Tinkerforge/tng-ao-4u-4i/hardware/ao-4u-4i.kicad_pcb

## KiCad design hardware/ao-4u-4i.kicad_pcb (2020-09-10)

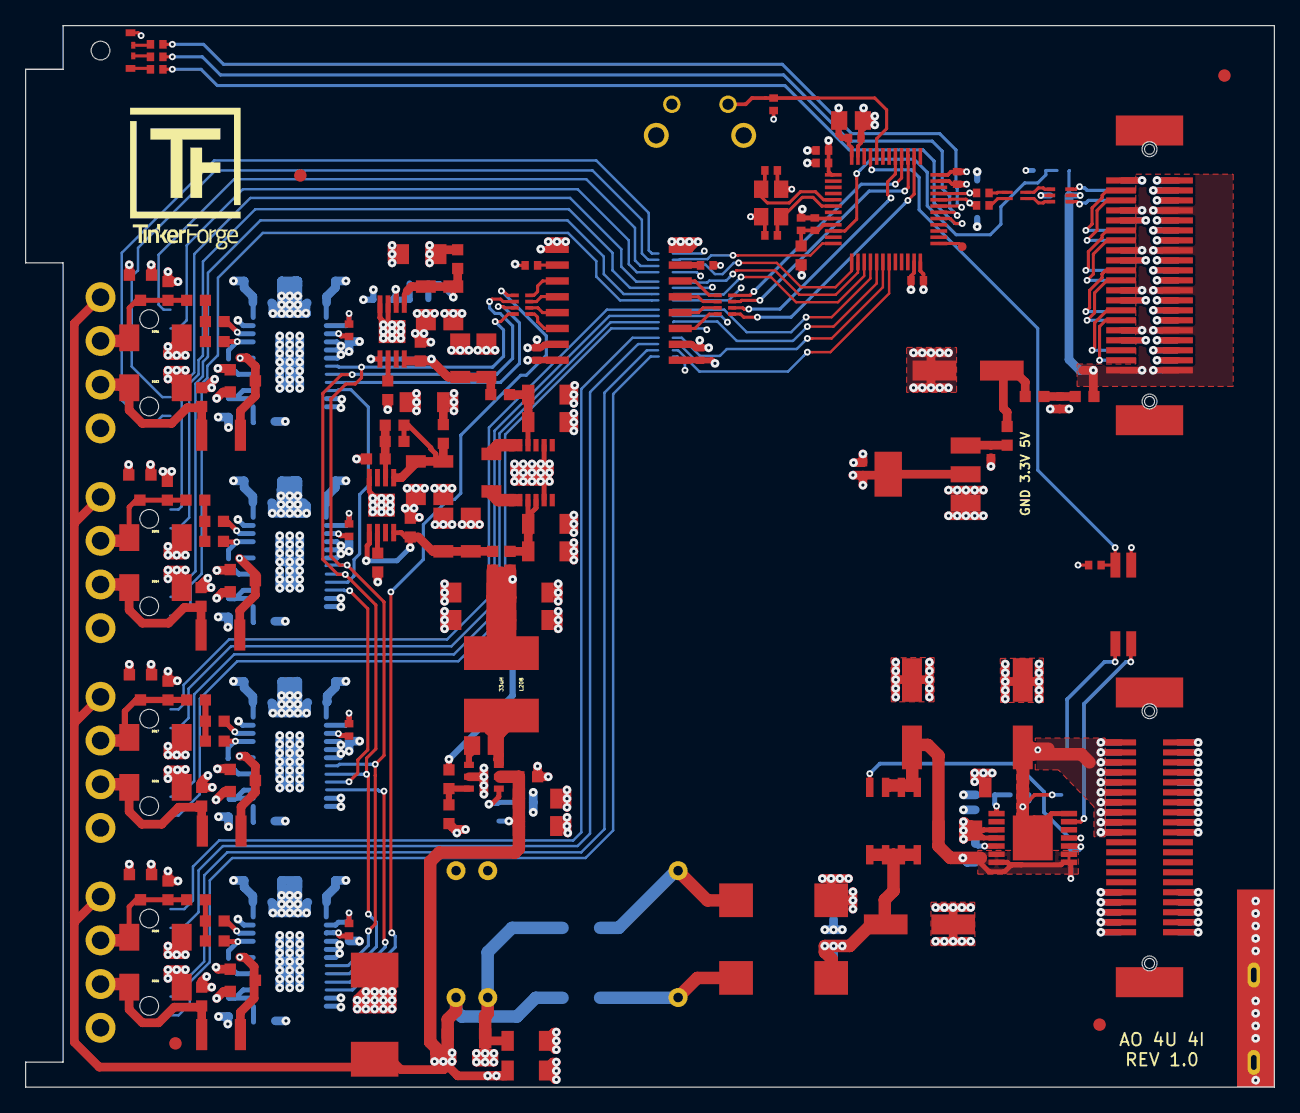
[picture p1: board ao-4u-4i.kicad_pcb from above]

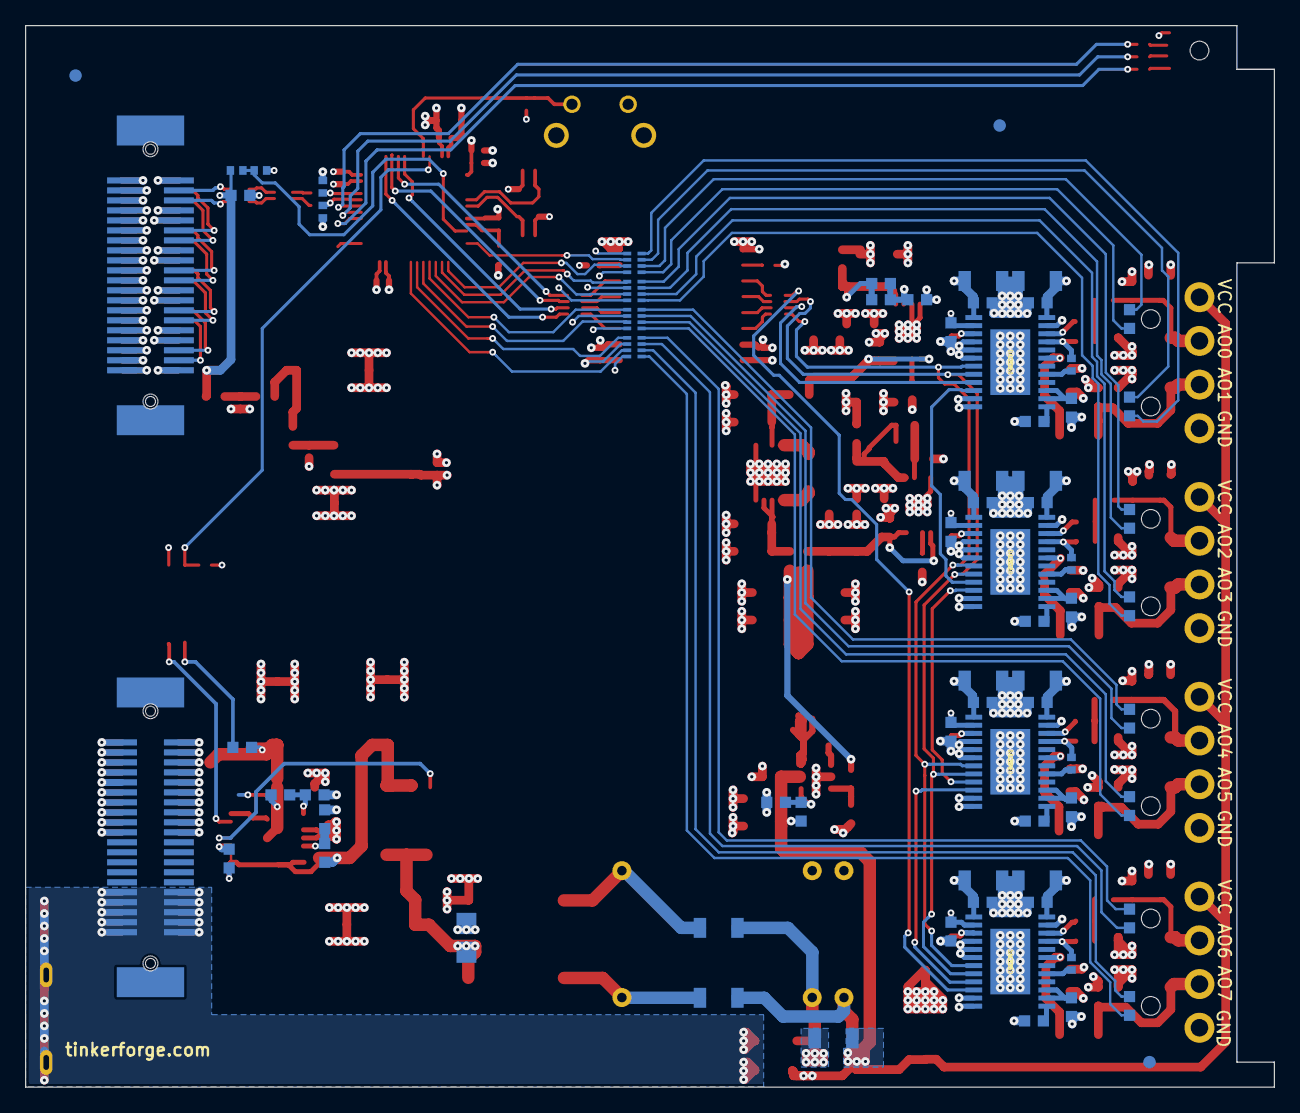
[picture p2: board ao-4u-4i.kicad_pcb from below]

Board: 4 copper layers, 100.0 x 85.0 mm, 224 parts (73 on the bottom side), 158 nets.

Parts:
C101, C102, C116, C117: 1uF; C0402F
C103, C104, C105, C106, C107, C112, C233, C235: 100nF; C0402F
C108, C109: 33pF; C0402F
C110: 10uF; C0805E
C111, C122, C123, C124: 100uF/35V; ELKO_63
C113, C114: 47pF; C0402F
C115: 2.2uF; C0603F
C118: 10uF/50V; C1206
C119, C120: 0; C1206
C121, C125, C126: 10uF/35V; C1206
C127, C128: 1nF/2kV; C1206
C201, C202, C203, C204, C207, C209, C211, C212, C213, C215, C217, C218, C219, C220, C221, C222, C225, C227, C229, C230, C231, C234, C237, C238, C245, C246, C258: 100nF/30V; C0603F
C205, C206, C223, C224: 1nF; C0402F
C208, C210, C214, C216, C226, C228, C232, C236, C239, C242: 4.7uF/30V; C1206
C240, C241, C243, C244, C247, C251, C252, C255, C257, C259, C260, C261, C262, C263, C264, C265, C266, C267: 4.7uF/50V; C1206
C248, C249, C253, C254: 10nF/30V; C0603F
C250: 100nF/100V; C0805E
C256: 1uF/50V; C1206
D101: 3.0SMI30CATR; SMC
D201, D202, D213, D214, D217, D218, D221, D222: SMBJ18CA; SMB
D203, D204, D205, D206, D207, D208, D209, D210: LED; LED-LP
D211, D212, D215, D216, D219, D220, D223, D224: CDSOT23-T15C; SOT23-3
Fiducial_Mark: VAL**; Fiducial_Mark
Fiducial_Mark#2, Fiducial_Mark#3, Fiducial_Mark#4, Fiducial_Mark#5, Fiducial_Mark#6, Fiducial_Mark#7: VAL**; Fiducial_Mark
J101: TNG-Power-TOP; TNG-40-TOP
J102: TNG-Power-BTM; TNG-40-BTM
J103: TNG-Data-TOP; TNG-40-TOP
J104: TNG-Data-BTM; TNG-40-BTM
L101: FB; R0603F
L102, L103, L104: INDUCTs; R0603F
L105: 744230900; WE-CNSW-0603
L201, L202, L203, L204, L205, L206, L207, L209, L210: FB; C0603F
L208: 33uH; SRN6045
LED101: EASV3015RGBA0; LED-RGB-LP
P102: Debug; DEBUG_PAD
P103: PE; PE_Hook
P201: OUTPUT0; OQ_4P
P202: OUTPUT1; OQ_4P
P203: OUTPUT2; OQ_4P
P204: OUTPUT3; OQ_4P
Q101: FDS8449; SOIC-8-MOSFET
R101, R107, R108: 1k; R0402F
R102, R105, R221, R254: 0; R0402F
R103, R104: 22; R0402F
R106: 56; R0402F
R109, R209, R210, R219, R220: 10k; R0402F
R110, R115: 10k; R0603F
R111, R112: DNP; R0603F
R113: 22; R0603F
R114: 68k; R0603F
R116: VC1206K201R030; R1206
R201, R202, R204, R205, R211, R212, R214, R215: 15; R0603F
R203, R206, R213, R216: 15 1/2W 1%; R1210
R207, R208, R217, R218: 15k 0.1%; R0603F
R222: 127k; R0603F
R223: 1.37M; R0603F
R224, R227: 110k; R0603F
R225, R226: 9.42k; R0603F
R228: 374k; R0603F
R229: 22.1k; R0603F
RP201, RP202, RP203, RP204, RP205, RP206: 470; 4X0402
SW101: BOOT; TACT-6MM-HOR
T101: 744273222; WE-SL5
U101: STM32F070CBT6; LQFP48
U102: AZ1117EH; SOT-223
U103: 82400152; SOT563-SPEC
U104: DNP; TEL10
U105: TLP293; SOP4
U106: STEF01; HTSSOP14
U201, U202, U204, U205: DAC8760; TSSOP24-44-PWR
U203: ISO7741DWR; SOIC16_WIDE
U206: TPS560430YDBVR; SOT23-6
U207: TPS7A3001DGNR; MSOP-8-EP
U208: TPS7A4901DGNR; MSOP-8-EP
U209: LTC3261; MSOP12_EXP
X101: 8MHz; CRYSTAL_3225

Connections:
3V3: C101.1, C103.1, C104.1, C105.1, C106.1, C110.1, C116.1, C235.1, L101.1, LED101.1, R109.2, R254.1, RP201.1, RP201.4, RP202.2, RP202.4, RP203.2, RP203.4, RP204.2, RP204.4, SW101.1, U101.1, U101.24, U101.36, U101.48, U102.2, U203.1
5VA: C115.1, J103.7, J103.8, J103.15, J103.16, J103.23, J103.24, J103.31, J103.32, J103.39, J103.40, J104.7, J104.8, J104.15, J104.16, J104.23, J104.24, J104.31, J104.32, J104.39, J104.40, L104.1, R107.1, U103.5
+5V: C111.1, L102.1, L103.2
+15V: C207.2, C208.2, C209.2, C210.2, C225.2, C226.2, C227.2, C228.2, C240.2, D211.2, D212.2, D215.2, D216.2, D219.2, D220.2, D223.2, D224.2, L206.2, U201.24, U202.24, U204.24, U205.24
-15V: C213.1, C214.1, C215.1, C216.1, C231.1, C232.1, C234.1, C236.1, C265.2, D211.1, D212.1, D215.1, D216.1, D219.1, D220.1, D223.1, D224.1, L209.2, U201.1, U201.EP, U202.1, U202.EP, U204.1, U204.EP, U205.1, U205.EP
AGND: C118.2, C120.1, C128.2, C201.1, C202.1, C203.1, C204.1, C207.1, C208.1, C209.1, C210.1, C211.1, C212.1, C213.2, C214.2, C215.2, C216.2, C217.1, C218.1, C219.1, C220.1, C221.1, C222.1, C225.1, C226.1, C227.1, C228.1, C229.1, C230.1, C231.2, C232.2, C233.2, C234.2, C236.2, C237.1, C238.1, C239.1, C240.1, C241.1, C242.1, C243.1, C244.1, C245.1, C246.2, C247.1, C248.1, C251.1, C252.1, C254.1, C255.1, C257.1, C258.2, C259.1, C260.1, C261.1, C262.1, C263.1, C264.1, C265.1, C266.1, C267.1, D101.2, D201.1, D202.1, D213.1, D214.1, D217.1, D218.1, D221.1, D222.1, P201.4, P202.4, P203.4, P204.4, R116.2, R207.2, R208.2, R217.2, R218.2, R222.2, R225.1, R226.1, R229.1, U104.10, U201.4, U201.5, U201.6, U201.11, U201.12, U201.23, U202.4, U202.5, U202.6, U202.11, U202.12, U202.23, U203.9, U203.15, U204.4, U204.5, U204.6, U204.11, U204.12, U204.23, U205.4, U205.5, U205.6, U205.11, U205.12, U205.23, U206.2, U207.3, U207.4, U207.EP, U208.4, U208.EP, U209.2, U209.11, U209.EXP
AGNDA: C121.2, C122.2, C123.2, C124.2, C125.2, C126.2, J101.2, J101.4, J101.6, J101.8, J101.10, J101.12, J101.14, J101.16, J101.18, J101.20, J102.1, J102.3, J102.5, J102.7, J102.9, J102.11, J102.13, J102.15, J102.17, J102.19, R112.2, R115.2, T101.2, U106.3, U106.4
AIN0: R107.2, R108.1, U101.10
DVDD: C217.2, C233.1, R209.2, R221.2, U201.2, U203.16
Earth: C127.2, C128.1, J101.31, J101.32, J101.33, J101.34, J101.35, J101.36, J101.37, J101.38, J101.39, J101.40, J102.31, J102.32, J102.33, J102.34, J102.35, J102.36, J102.37, J102.38, J102.39, J102.40, P103.1
GND: C101.2, C102.2, C103.2, C104.2, C105.2, C106.2, C107.2, C108.1, C109.1, C110.2, C111.2, C112.2, C113.2, C114.2, C115.2, C116.2, C117.2, C235.2, J103.1, J103.2, J103.4, J103.6, J103.9, J103.10, J103.12, J103.14, J103.17, J103.18, J103.20, J103.22, J103.25, J103.26, J103.28, J103.30, J103.33, J103.34, J103.36, J103.38, J104.1, J104.2, J104.3, J104.5, J104.9, J104.10, J104.11, J104.13, J104.17, J104.18, J104.19, J104.21, J104.25, J104.26, J104.27, J104.29, J104.33, J104.34, J104.35, J104.37, R101.1, R108.2, U101.8, U101.23, U101.35, U101.47, U102.1, U103.2, U105.3, U203.2, U203.8, X101.3
LED0: RP201.2, U101.12
LED1: RP201.3, U101.13
LED2: RP202.1, U101.14
LED3: RP202.3, U101.15
LED4: RP203.1, U101.16
LED5: RP203.3, U101.17
LED6: RP204.1, U101.18
LED7: RP204.3, U101.19
LEDB: R106.1, U101.31
LEDG: R105.1, U101.30
LEDR: R102.1, U101.29
unnamed: C102.1, C107.1, L101.2, U101.9
unnamed: C108.2, U101.5, X101.2
unnamed: C109.2, U101.6, X101.1
unnamed: C112.1, L103.1, L104.2
unnamed: C117.1, L102.2, U102.3
unnamed: C119.2, T101.4, U104.16
unnamed: C120.2, T101.3, U104.1
unnamed: C121.1, C123.1, Q101.D, T101.1
unnamed: C201.2, D201.2, D211.3, L201.2, P201.2
unnamed: C202.2, D202.2, D212.3, L203.2, P202.2
unnamed: C203.2, D213.2, P201.3, R203.1
unnamed: C204.2, D214.2, P202.3, R206.1
unnamed: C205.1, U201.17
unnamed: C205.2, R202.2, U201.21
unnamed: C206.1, U202.17
unnamed: C206.2, R205.2, U202.21
unnamed: C211.2, U201.14, U201.15
unnamed: C212.2, U202.14, U202.15
unnamed: C218.2, R210.2, U202.2
unnamed: C219.2, D217.2, D219.3, L204.2, P203.2
unnamed: C220.2, D218.2, D220.3, L205.2, P204.2
unnamed: C221.2, D221.2, P203.3, R213.1
unnamed: C222.2, D222.2, P204.3, R216.1
unnamed: C223.1, U204.17
unnamed: C223.2, R212.2, U204.21
unnamed: C224.1, U205.17
unnamed: C224.2, R215.2, U205.21
unnamed: C229.2, U204.14, U204.15
unnamed: C230.2, U205.14, U205.15
unnamed: C237.2, R219.2, U204.2
unnamed: C238.2, R220.2, U205.2
unnamed: C241.2, C243.2, C246.1, L207.1, U207.5, U207.8
unnamed: C244.2, C247.2, C249.1, L206.1, R224.2, U208.1
unnamed: C248.2, U207.6
unnamed: C249.2, R224.1, R225.2, U208.2
unnamed: C250.1, L208.1, U206.6
unnamed: C250.2, U206.1
unnamed: C251.2, C252.2, L207.2, U209.4
unnamed: C253.1, C257.2, C260.2, L209.1, R227.2, U207.1
unnamed: C253.2, R226.2, R227.1, U207.2
unnamed: C254.2, U208.6
unnamed: C255.2, C259.2, C262.2, C267.2, L202.2, L208.2, L210.2, R228.2
unnamed: C256.1, U209.5, U209.6
unnamed: C256.2, U209.7, U209.8
unnamed: C258.1, C261.2, C264.2, L202.1, U208.5, U208.8
unnamed: C263.2, C266.2, L210.1, U209.9, U209.10
unnamed: D203.1, RP201.5
unnamed: D203.2, RP201.6
unnamed: D204.1, RP201.8
unnamed: D204.2, RP201.7
unnamed: D205.1, RP202.7
unnamed: D205.2, RP202.8
unnamed: D206.1, RP202.5
unnamed: D206.2, RP202.6
unnamed: D207.1, RP203.7
unnamed: D207.2, RP203.8
unnamed: D208.1, RP203.5
unnamed: D208.2, RP203.6
unnamed: D209.1, RP204.7
unnamed: D209.2, RP204.8
unnamed: D210.1, RP204.5
unnamed: D210.2, RP204.6
unnamed: D215.3, R203.2, U201.19
unnamed: D216.3, R206.2, U202.19
unnamed: D223.3, R213.2, U204.19
unnamed: D224.3, R216.2, U205.19
unnamed: J103.3, J104.12
unnamed: J103.5, J104.14
unnamed: J103.11, J104.20
unnamed: J103.13, J104.22
unnamed: J103.19, J104.28
unnamed: J103.21, J104.30
unnamed: J103.27, J104.36
unnamed: J103.29, J104.38
unnamed: L201.1, R201.1, R202.1
unnamed: L203.1, R204.1, R205.1
unnamed: L204.1, R211.1, R212.1
unnamed: L205.1, R214.1, R215.1
unnamed: LED101.2, R106.2
unnamed: LED101.3, R105.2
unnamed: LED101.4, R102.2
unnamed: P102.1, U101.25
unnamed: Q101.G, U106.11
unnamed: R101.2, SW101.2, U101.44
unnamed: R110.2, U105.1
unnamed: R111.2, R112.1, U106.5
unnamed: R113.2, U106.10
unnamed: R114.2, R115.1, U106.1
unnamed: R201.2, U201.22
unnamed: R204.2, U202.22
unnamed: R207.1, U201.13
unnamed: R208.1, U202.13
unnamed: R209.1, U201.3
unnamed: R210.1, U202.3
unnamed: R211.2, U204.22
unnamed: R214.2, U205.22
unnamed: R217.1, U204.13
unnamed: R218.1, U205.13
unnamed: R219.1, U204.3
unnamed: R220.1, U205.3
unnamed: R221.1, U203.10
unnamed: R222.1, R223.1, U206.4
unnamed: R228.1, R229.2, U206.3
unnamed: R254.2, U203.7
unnamed: RP205.1, U203.14
unnamed: RP205.2, U203.13
unnamed: RP205.3, U203.12
unnamed: RP205.4, U203.11
unnamed: RP206.5, U203.6
unnamed: RP206.6, U203.5
unnamed: RP206.7, U203.4
unnamed: RP206.8, U203.3
unnamed: U201.10, U202.9
unnamed: U202.10, U204.9
unnamed: U204.10, U205.9
PWR_GOOD: R109.1, U101.45, U105.4
PWR_PG: U105.2, U106.13
SPI-CLK: RP206.3, U101.39
SPI-LATCH: RP206.1, U101.38
SPI-MISO: RP206.4, U101.40
SPI-MOSI: RP206.2, U101.41
USB-DM: C114.1, R104.2, U101.32
USB-DMA: J104.6, U103.4
USB-DMB: L105.1, U103.3
USB-DMC: L105.2, R104.1
USB-DP: C113.1, R103.2, U101.33
USB-DPA: J104.4, U103.6
USB-DPB: L105.4, U103.1
USB-DPC: L105.3, R103.1
VCC: C118.1, C119.1, C127.1, C239.2, C242.2, C245.2, D101.1, P201.1, P202.1, P203.1, P204.1, R116.1, R223.2, U104.9, U206.5
VCCPWRA: C122.1, C126.1, J101.1, J101.3, J101.5, J101.7, J101.9, J101.11, J101.13, J101.15, J101.17, J101.19, J102.2, J102.4, J102.6, J102.8, J102.10, J102.12, J102.14, J102.16, J102.18, J102.20, R110.1, R114.1, U106.14, U106.EXP
VO: C124.1, C125.1, Q101.S, R111.1, R113.1, U106.6, U106.7, U106.8, U106.9
_SPI-CLK: RP205.6, U201.8, U202.8, U204.8, U205.8
_SPI-LATCH: RP205.8, U201.7, U202.7, U204.7, U205.7
_SPI-MISO: RP205.5, U205.10
_SPI-MOSI: RP205.7, U201.9
