Tinkerforge/tng-ao-4u-4i/software/src/main.c

/* tng-ao-4u-4i
 * Copyright (C) 2019-2020 Olaf Lüke <olaf@tinkerforge.com>
 *
 * main.c: Initialization for TNG-AO-4U-4I
 *
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
 * You should have received a copy of the GNU Lesser General Public
 * License along with this library; if not, write to the
 * Free Software Foundation, Inc., 59 Temple Place - Suite 330,
 * Boston, MA 02111-1307, USA.
 */

#include "configs/config.h"

#include "bricklib2/tng/tng.h"
#include "bricklib2/logging/logging.h"
#include "dac8760.h"

int main(void) {
	logging_init();
	logd("Start TNG-AO-4U-4I\n\r");

	dac8760_init();

	while(true) {
		tng_tick();
		dac8760_tick();
	}
}
