Tinkerforge/tng-ao-4u-4i/(commit log)

2020-01-02 start with schematic
    [analog.sch, ao-4u-4i.kicad_pcb, ao-4u-4i.sch]
2020-01-03 footprint draft finished
    [analog.sch]
2020-01-03 placement draft
    [analog.sch, ao-4u-4i.kicad_pcb]
2020-01-06 placement complete
    [analog.sch, ao-4u-4i.kicad_pcb]
2020-01-06 some routing
    [ao-4u-4i.kicad_pcb]
2020-01-20 more routing
    [ao-4u-4i.kicad_pcb]
2020-03-02 fix footprint spacing, fix description
    [analog.sch, ao-4u-4i.kicad_pcb]
2020-03-02 add hook footprint
    [ao-4u-4i.kicad_pcb]
2020-03-17 change esd diodes
    [analog.sch, ao-4u-4i.kicad_pcb]
2020-05-14 fix values
    [ao-4u-4i.kicad_pcb, ao-4u-4i.sch]
2020-05-14 specify value
    [ao-4u-4i.kicad_pcb, ao-4u-4i.sch]
2020-07-02 fix diode values
    [analog.sch, ao-4u-4i.kicad_pcb]
2020-07-03 fix isolator enable resistors
    [analog.sch, ao-4u-4i.kicad_pcb]
2020-07-03 fix diodes
    [analog.sch, ao-4u-4i.kicad_pcb]
2020-07-20 Add initial firmware
    with
    * DAC8760 driver and
    * initial simplified API
2020-07-27 Add TIM defines for status LEDs
2020-09-04 add version 1,1
    fix footprints
    [analog.sch, ao-4u-4i.kicad_pcb, ao-4u-4i.sch]
2020-09-04 fix text layer
    [ao-4u-4i.kicad_pcb]
2020-09-04 fix tbd
    [ao-4u-4i.kicad_pcb, ao-4u-4i.sch]
2020-09-04 fix diode orientation
    [analog.sch, ao-4u-4i.kicad_pcb]
2020-09-07 specify capacitors
    [ao-4u-4i.kicad_pcb, ao-4u-4i.sch]
2020-09-07 fix stuff
    [analog.sch, ao-4u-4i.kicad_pcb, ao-4u-4i.sch]
2020-09-07 improve routing
    [ao-4u-4i.kicad_pcb]
2020-09-08 all footprints updated
    [ao-4u-4i.kicad_pcb]
2020-09-09 remove galvanic isolation as default
    [ao-4u-4i.kicad_pcb, ao-4u-4i.sch]
2020-09-10 fix 3d stuff
    [ao-4u-4i.kicad_pcb]
