Tinkerforge/tng-ao-4u-4i/(notices)

Notices in the files:
hardware/analog.sch:
Licensed under CERN OHL v.1.1
Copyright (©) 2020, B.Nordmeyer
hardware/ao-4u-4i.sch:
Copyright Tinkerforge GmbH 2020.
This documentation describes Open Hardware and is licensed under the
CERN OHL v. 1.1.
